gabriel-lepetitaimon/VoxPopuli/PCB/Project Outputs for VoxPopuli/Job1.PDF

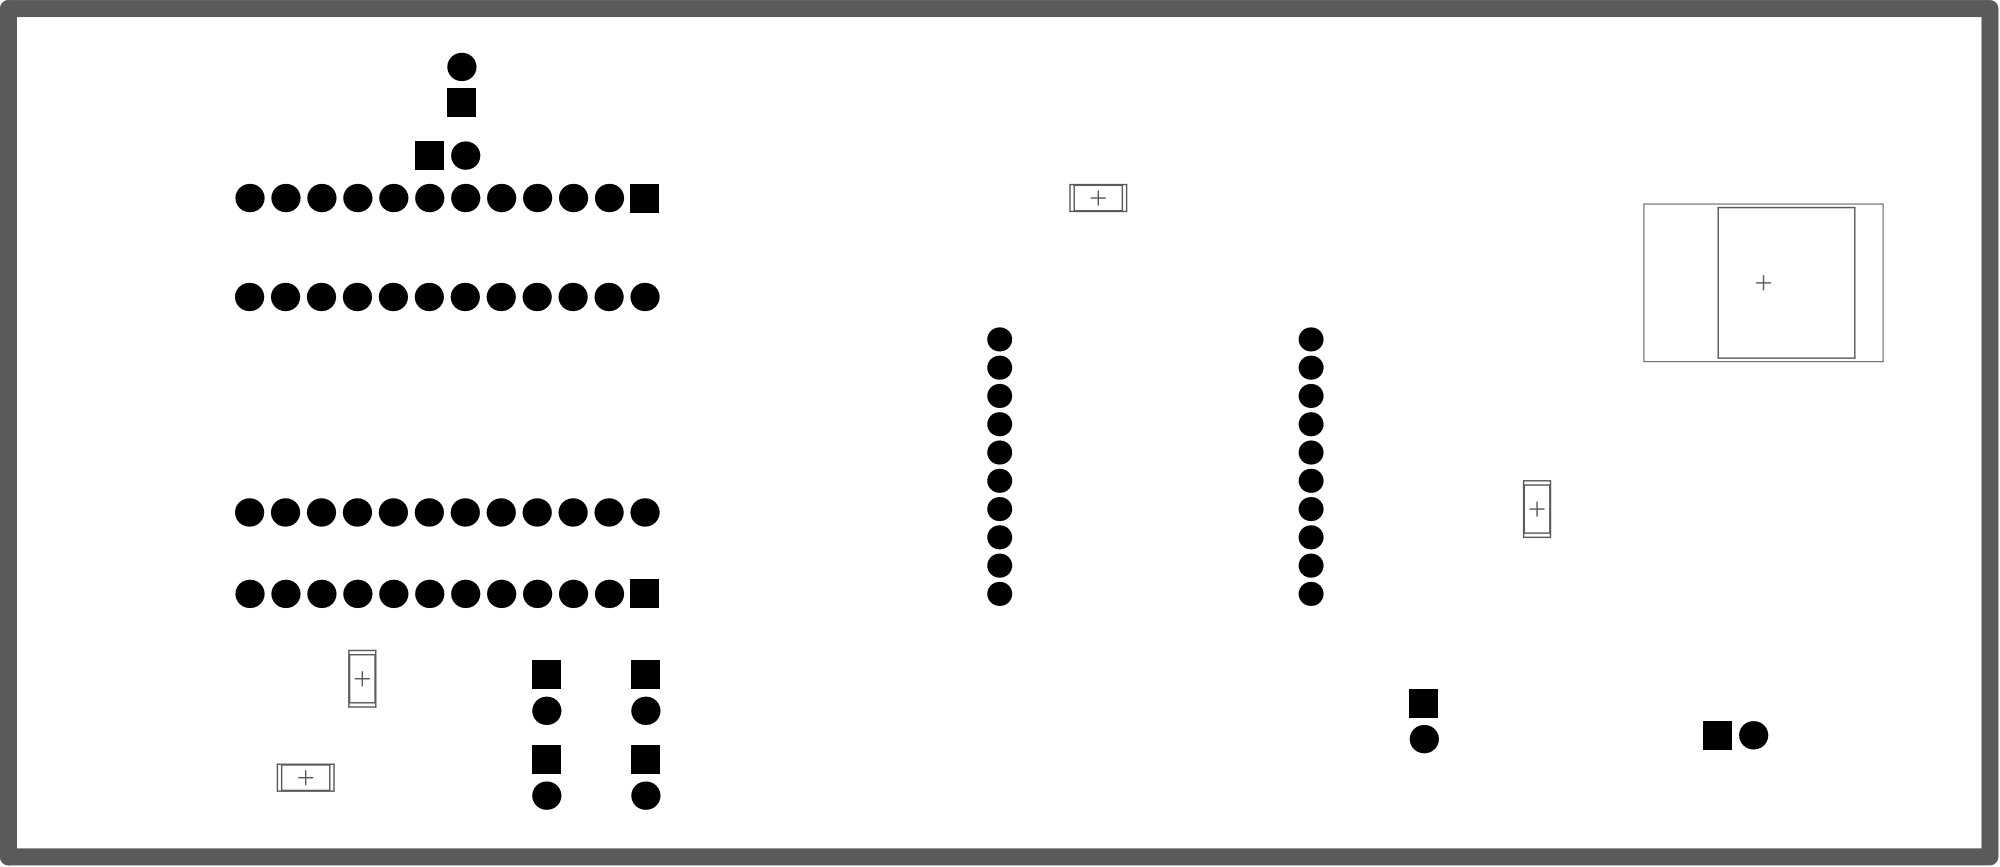
[picture p23: page 1]

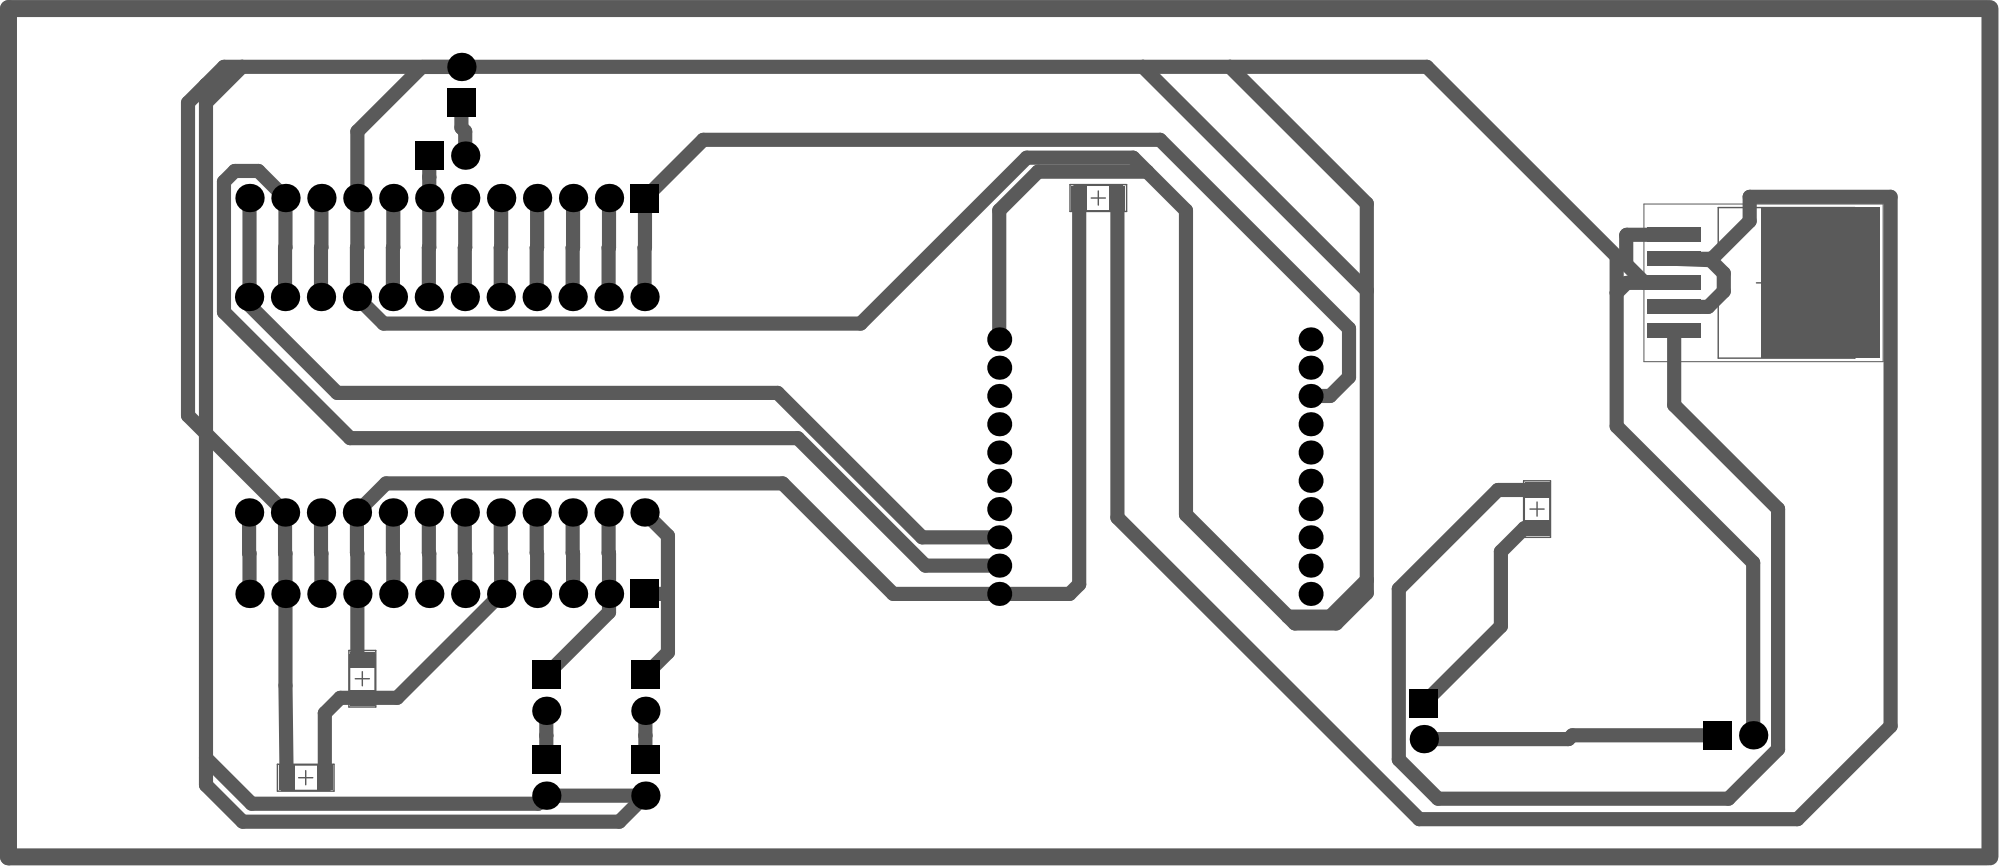
[picture p24: page 2]

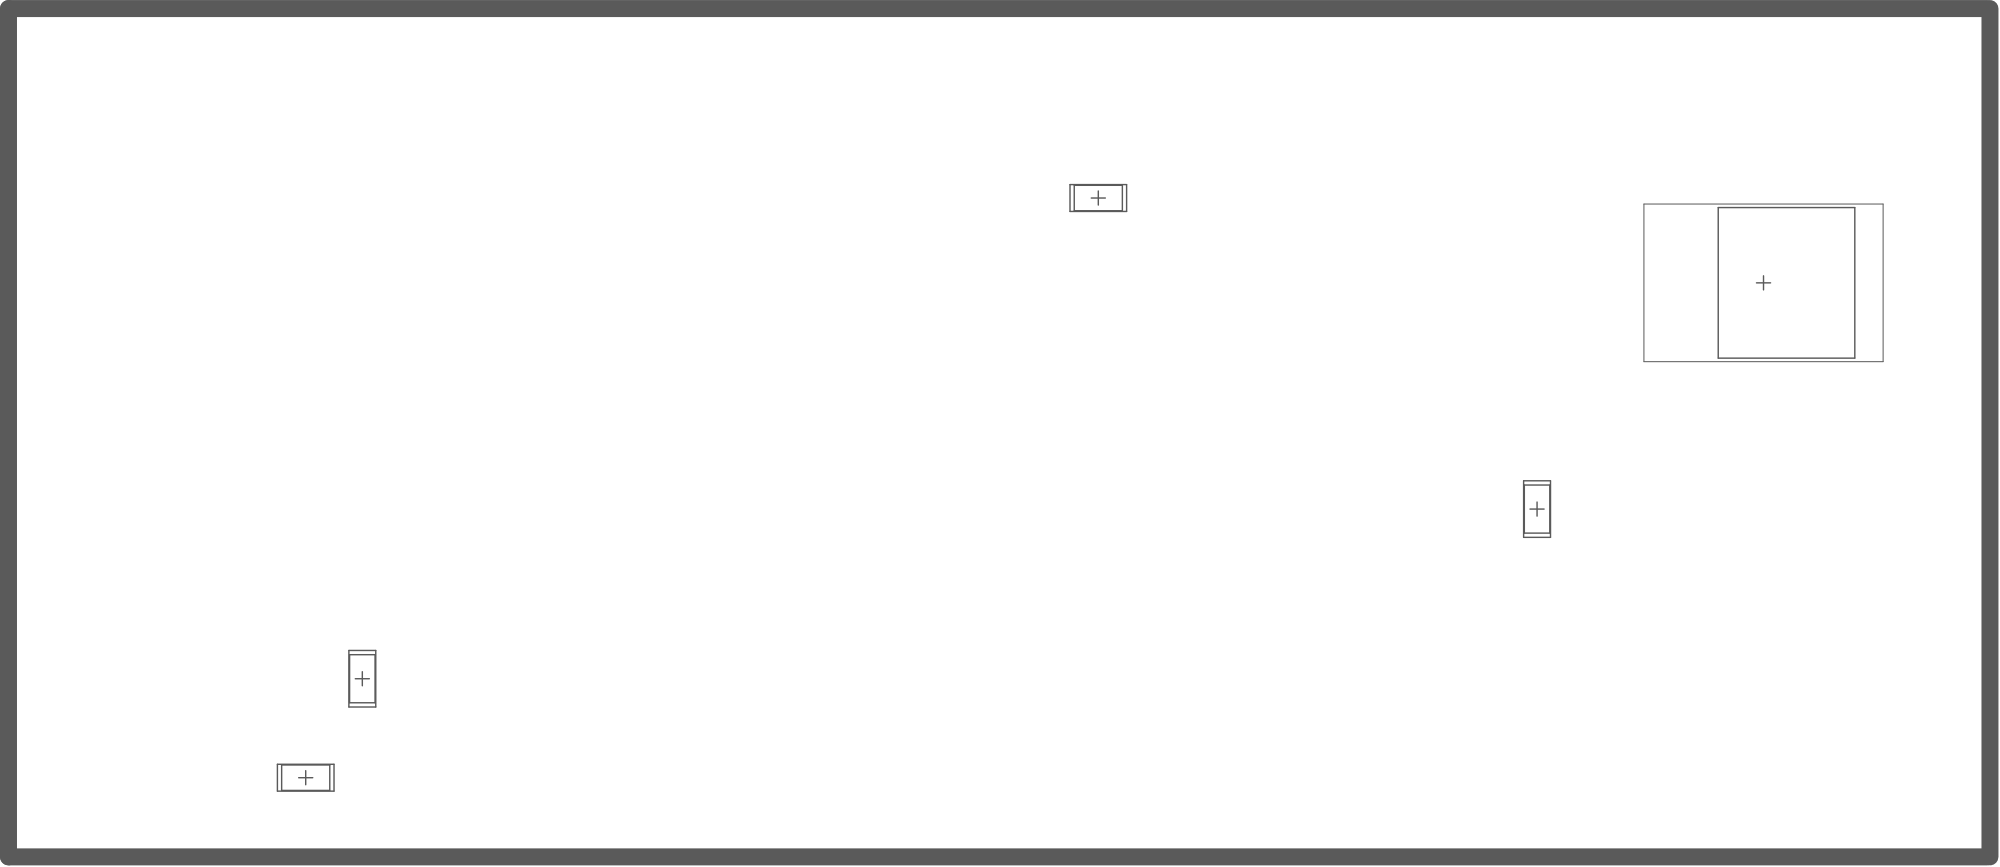
[picture p25: page 3]

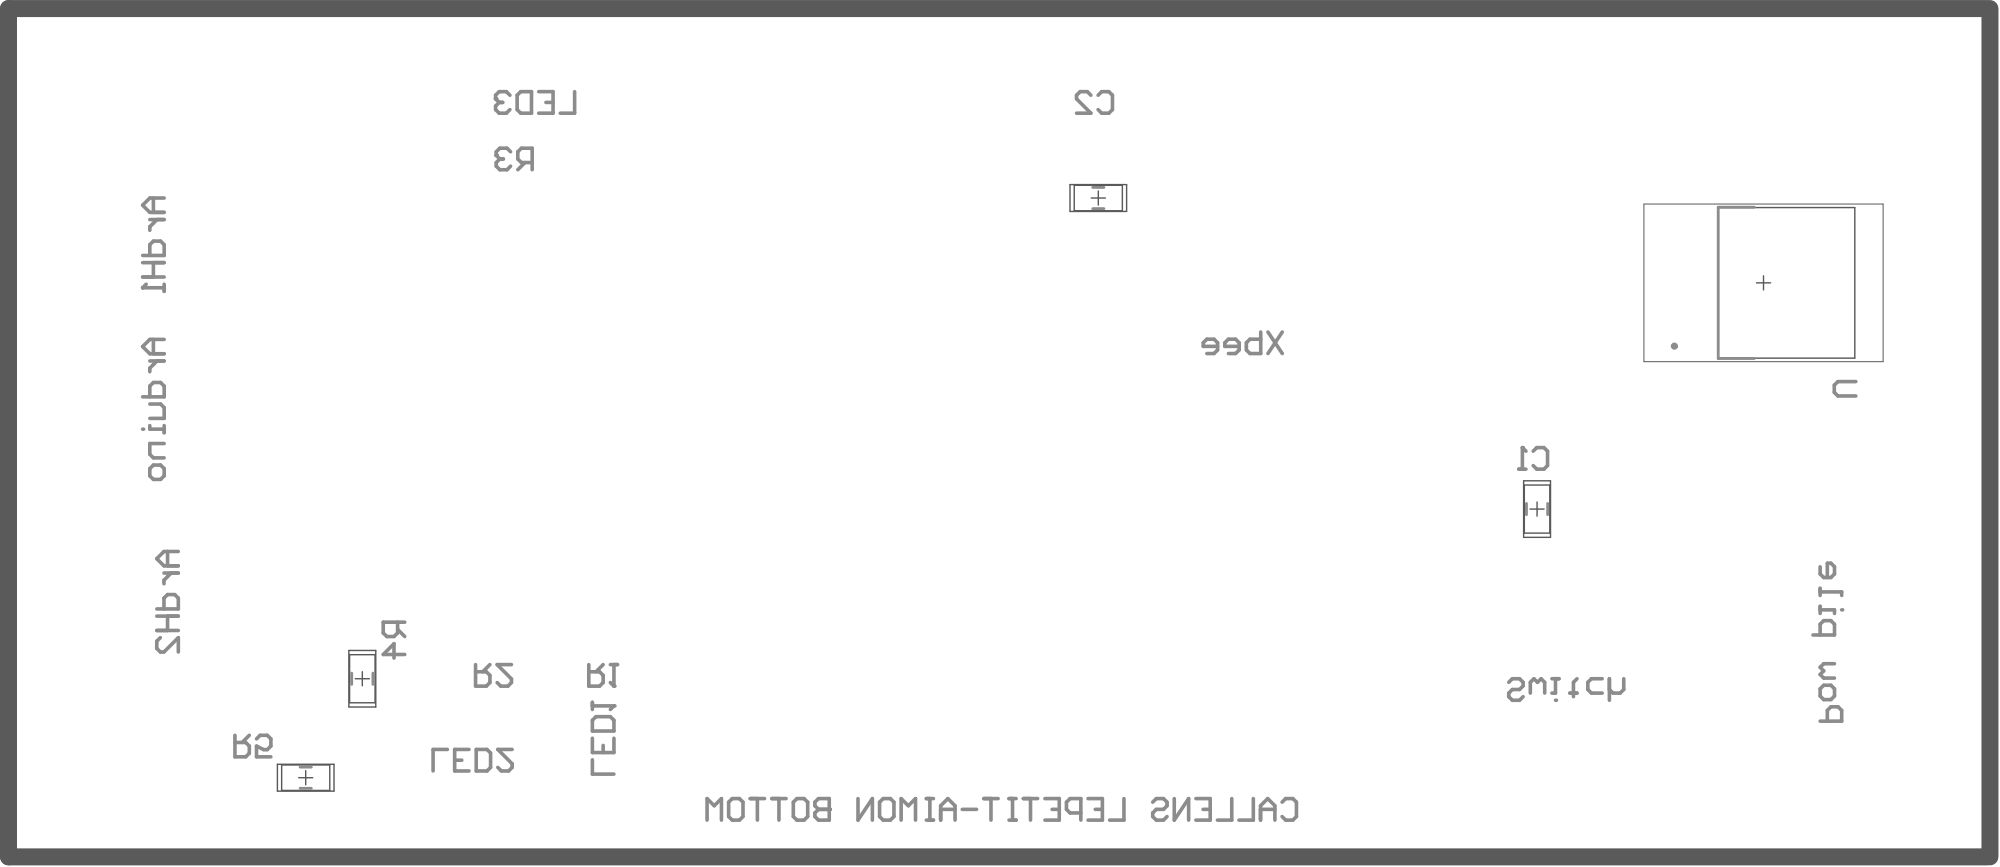
[picture p26: page 4]

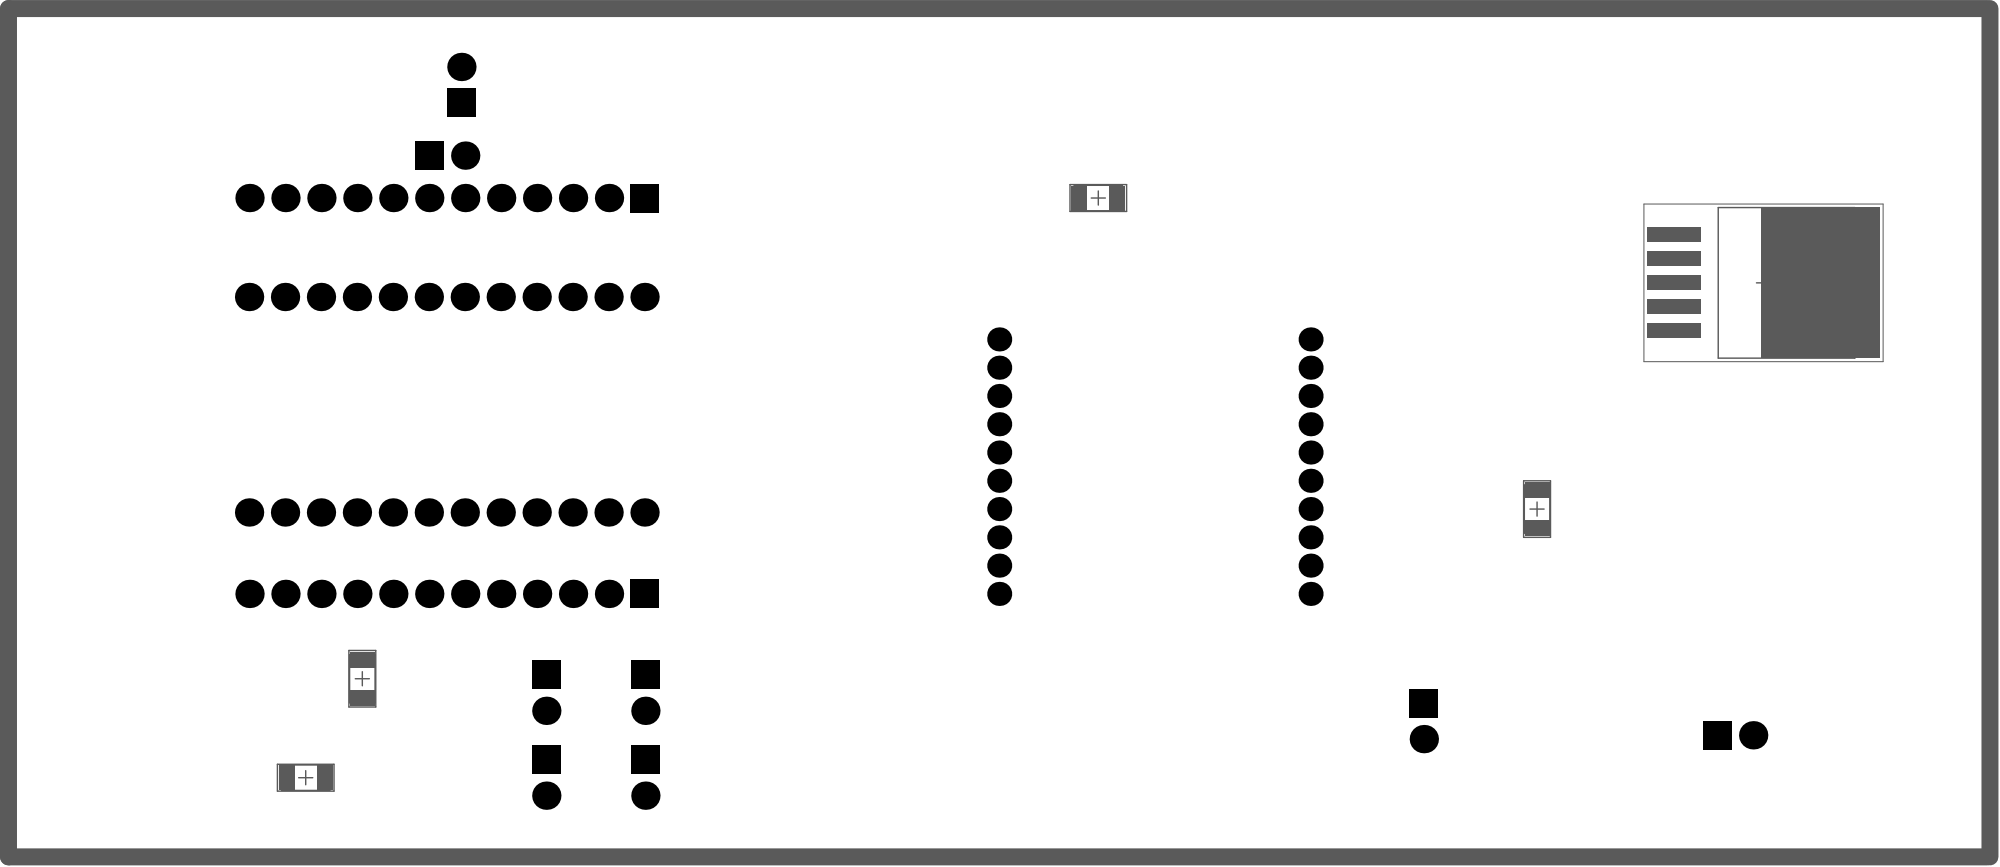
[picture p27: page 9]

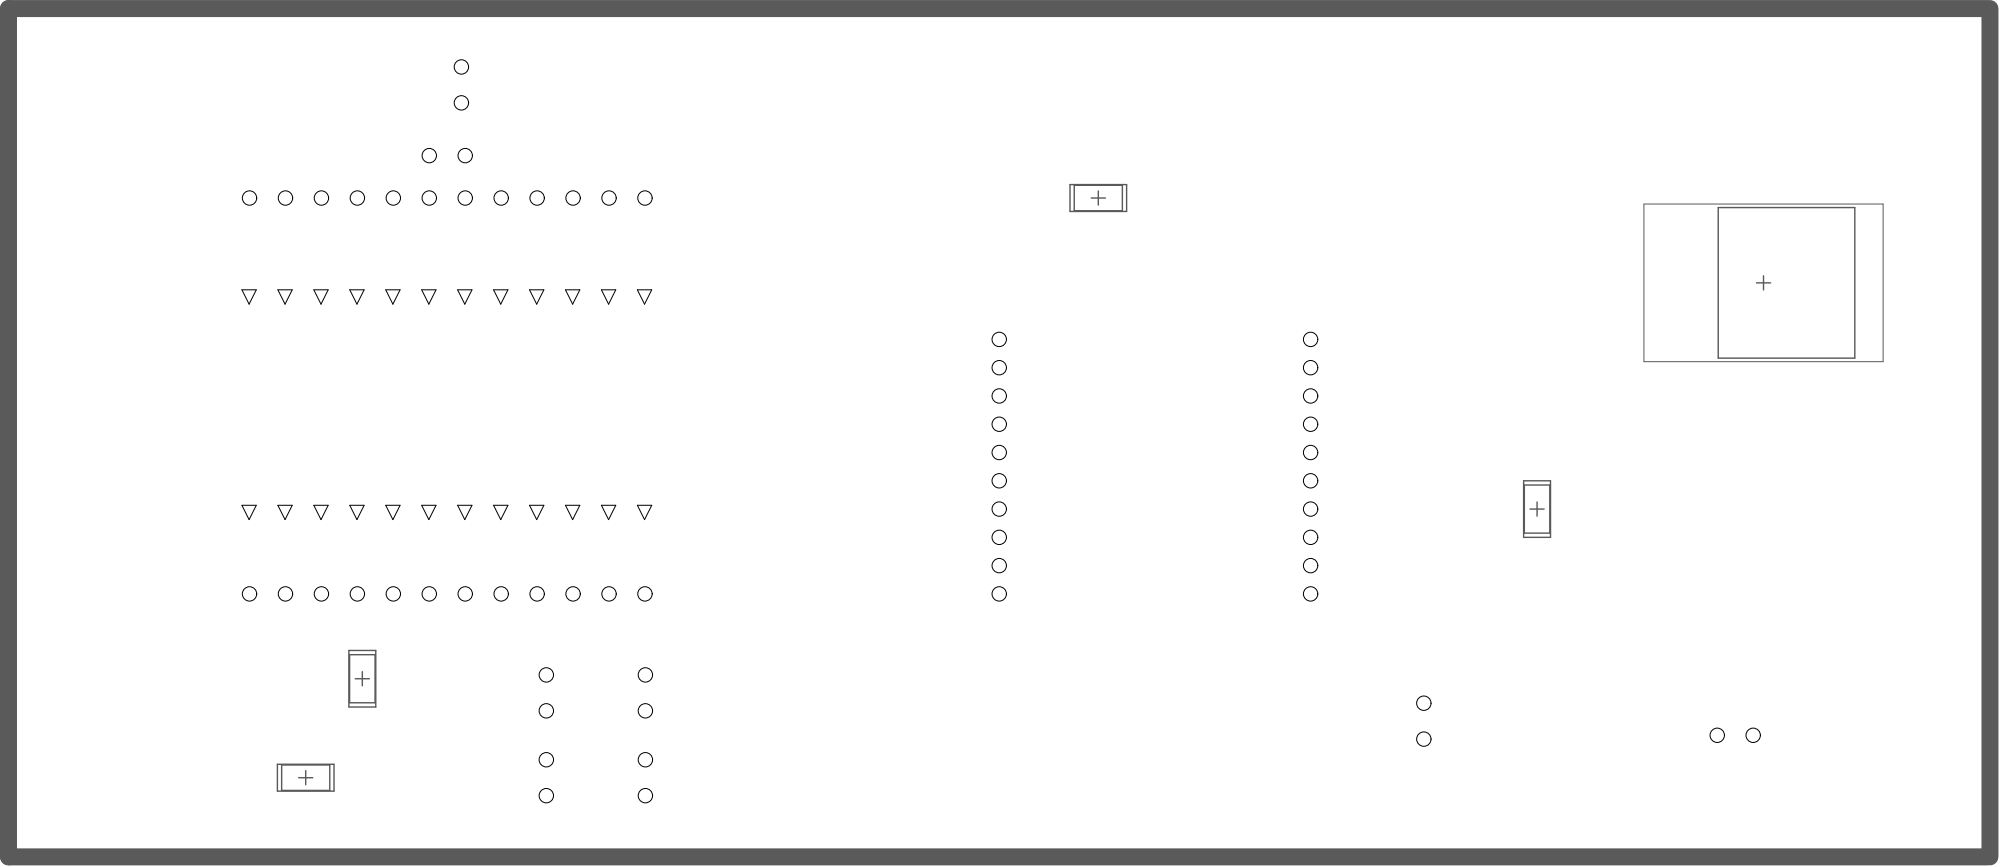
[picture p28: page 10]

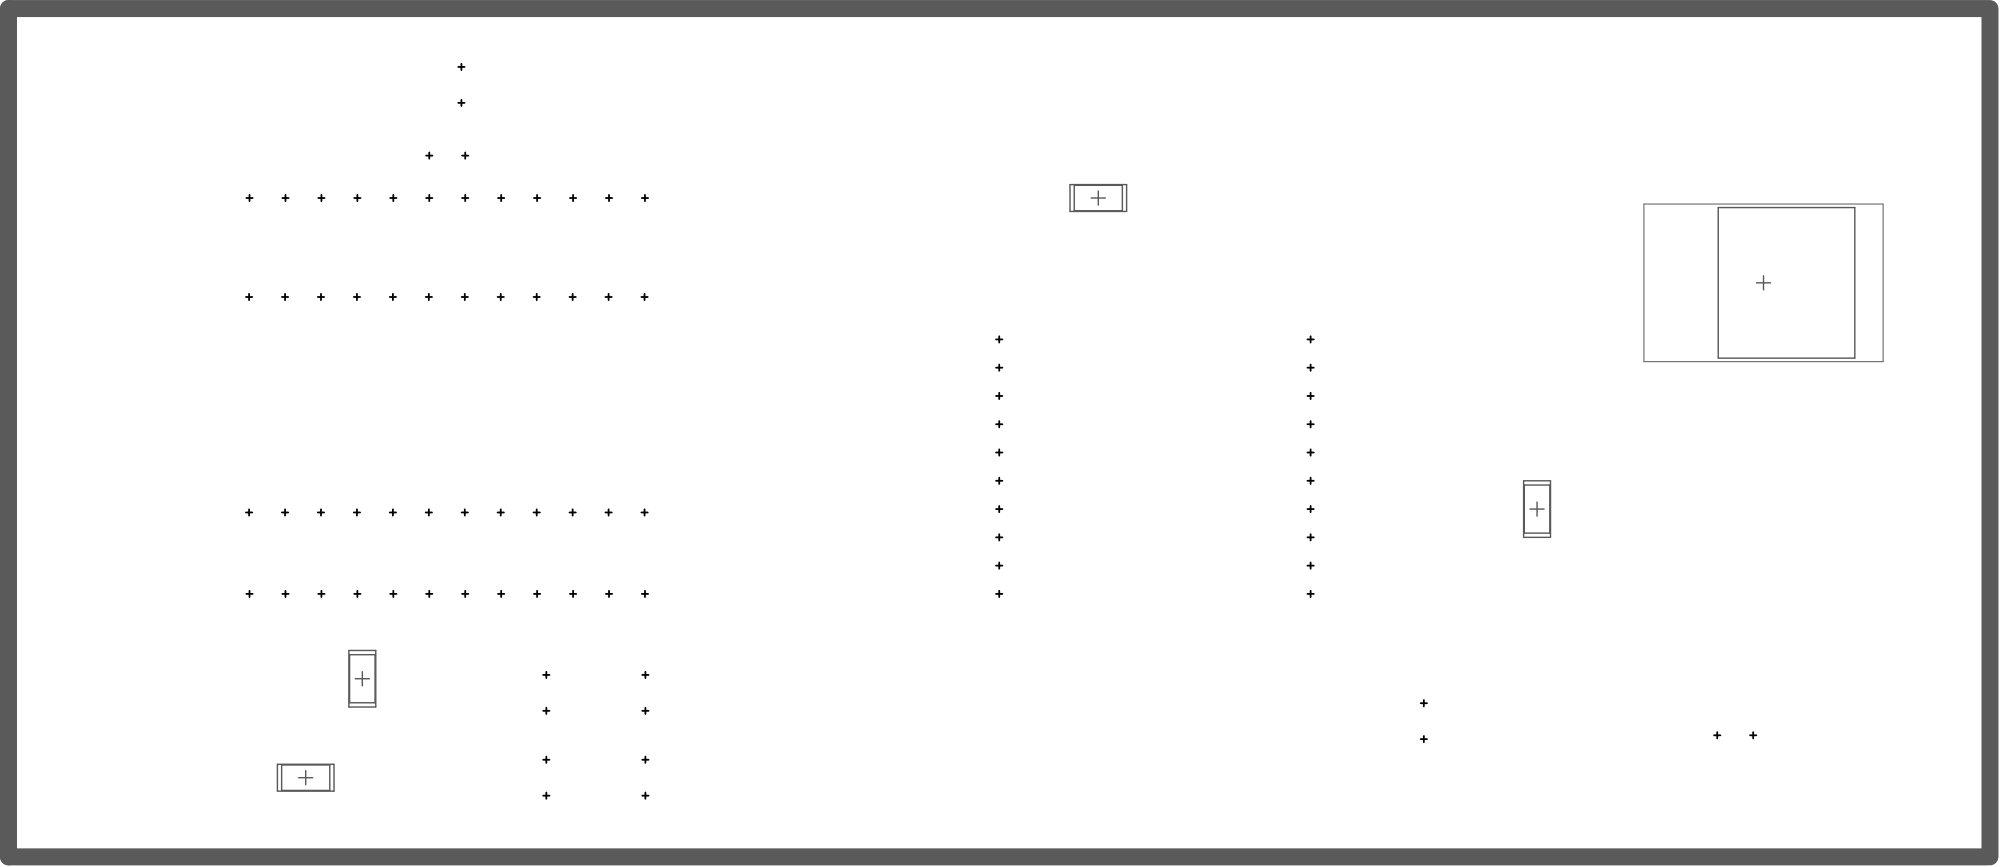
[picture p29: page 11]
