gabriel-lepetitaimon/VoxPopuli/PCB/Project Outputs for VoxPopuli/PCB_VoxPopuli_PRT_CALLENS.PDF

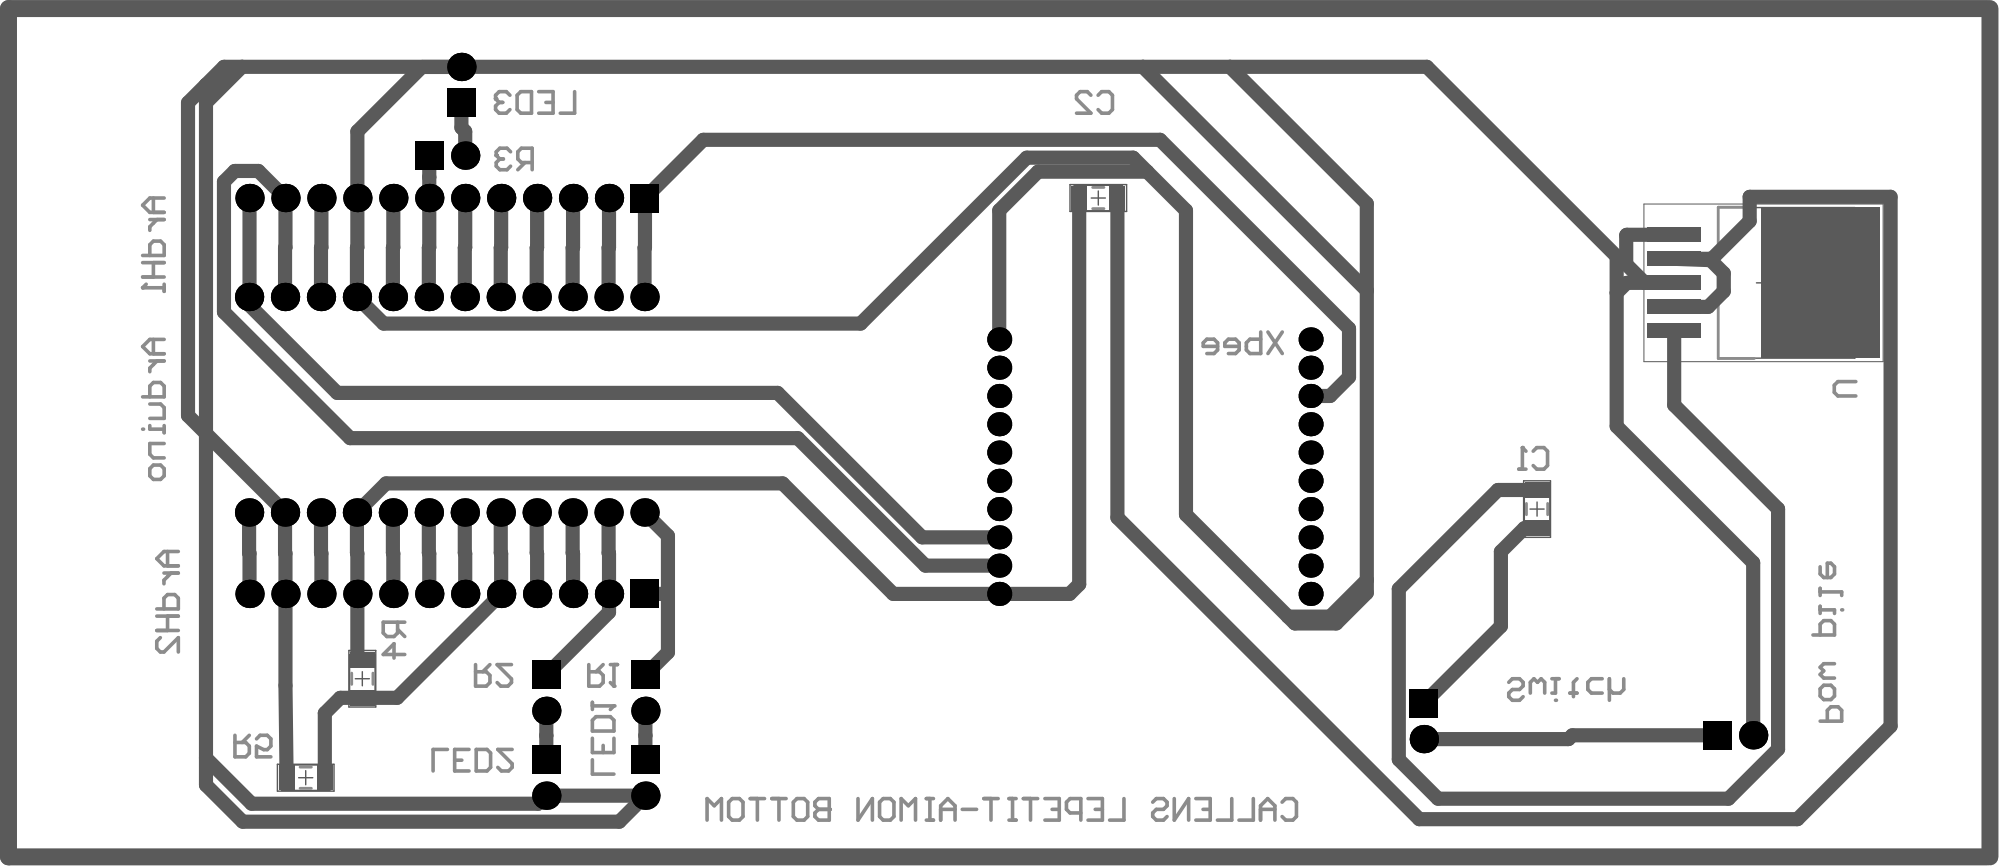
[picture p30: page 1]
