gabriel-lepetitaimon/VoxPopuli/(list of files, drawings)

Other design files:
PCB/Arduino System.SchLib
PCB/Arduino.PcbLib
PCB/VoxPopuli.PcbDoc
PCB/VoxPopuli.PcbLib
PCB/VoxPopuli.PrjPCB
PCB/VoxPopuli.SchDoc
PCB/VoxPopuli.SCHLIB
