gabriel-lepetitaimon/VoxPopuli/Software/src/Deamon/model/model.h

#ifndef JSONMODEL_H
#define JSONMODEL_H

#include <QObject>
#include <QString>
#include <QFile>
#include <QJsonDocument>
#include <QJsonObject>
#include <QFileSystemWatcher>
#include <QTimer>
#include <QVariant>
#include <functional>

#include <QDebug>

class JSonNode;
class JSonModel;

class JSonNode: public QObject
{
    Q_OBJECT

public:
    enum SetError{
        SameValue = -1,
        NoError = 0,
        DoesNotExist,
        ReadOnly,
        WrongArg
    };

    enum JSonNodeFlag{
        NO_JSON_FLAG = 0,
        RENAMEABLE = 0x01
    };


    const QString&      name()          const {return _name;}
    JSonNode*           nodeAt(QString name);
    JSonNode*           parentNode()    const {return _parentNode;}

    QString             address() const;
    QVariant get(const QString& name) const;
    bool getToString(const QString& name, QString &result) const;

    void printOut();
    virtual QString print() const;
    QStringList variablesNames() const;

    bool populateNode(const QJsonObject &data);

    const QMap<QString,QString> &getHelp(bool function);

    virtual ~JSonNode();

public slots:
    SetError set(const QString& name, const QString& value);
    bool call(const QString& functionName, const QStringList& arg, const std::function<void(QString)> &returnCb=[](QString){});

signals:
    void out(QString data);

protected:
    JSonNode(QString name, JSonNode *parent, const JSonNodeFlag& flags = NO_JSON_FLAG);

    virtual void updateParentJSon();
    virtual bool createSubNode(QString name, const QJsonObject& data);
    void addSubNode(JSonNode* node);
    void removeSubNode(JSonNode* node);
    void clearJsonData();

    virtual SetError setValue(QString name, QString value);
    JSonNode::SetError setString(QString name, QString value);
    SetError setNumber(QString name, QString value);
    SetError setNumber(QString name, double value);
    SetError setBool(QString name, QString value);
    SetError setBool(QString name, bool value);
    virtual SetError parseArray(QString name, QStringList value);
    virtual void valueChanged(QString name);

    virtual bool execFunction(QString function, QStringList args, const std::function<void(QString)>& cb=[](QString){});
    void printOut(QString msg);
    virtual void generateHelp(bool function) = 0;
    void addHelp(QString name, QString doc, bool function);
    QString helpString();

    bool rename(QString name);

    QString _name;
    const JSonNodeFlag _flags;
    QJsonObject _jsonData;
    JSonNode* _parentNode;

private:
    QList<JSonNode*> _subnodes;
    QMap<QString,QString> * _helpFunction = 0;
    QMap<QString,QString> * _helpVariables = 0;
};


#define JSON QDir::current().filePath(_name+".json")
class JSonModel : public JSonNode
{
    Q_OBJECT

public:
    JSonNode *nodeByAddress(QString address);
    virtual ~JSonModel();

    void init();

public slots:
    bool loadFile(QString path);
    bool saveToFile(QString path);
    bool resetFile();
    bool initFile();


protected:
    explicit JSonModel(QString name);
    void updateParentJSon();

protected slots:
    bool parseJSonFile();
    bool writeJSonFile();

signals:
    void startTimer();

private:
    void cleanJSon();

    QJsonDocument _jsonDoc;
    QFileSystemWatcher _watch;
    QTimer timer;

};

#endif // JSONMODEL_H
