gabriel-lepetitaimon/VoxPopuli/Software/src/Deamon/model/patch.cpp

#include <QJsonArray>

#include "patch.h"

#include "networkmodel.h"
#include "virtualnetwork.h"

/********************************************
 *              Patch                      *
 *******************************************/

Patch::Patch(NetworkModel *model)
    : JSonNode("Patch", model), _model(model)
{

}

bool Patch::execFunction(QString function, QStringList args, const std::function<void (QString)> &returnCb)
{
    if(function=="connect"){
        if(args.size()<2){
            returnCb("#Error: Wrong arguments number, expected remote and virtual remote names");
            return true;
        }
        addLink(args[0], args[1]);
        return true;
    }else if(function =="disconnect"){
        if(args.size()<2){
            returnCb("#Error: Wrong arguments number, expected remote and virtual remote names");
            return true;
        }
        removeLink(args[0], args[1]);
        return true;
    }else if(function == "disconnectRemote"){
        if(args.size()<1){
            returnCb("#Error: Wrong arguments number, expected remote name");
            return true;
        }
        removeRemoteLinks(args[0]);
        return true;
    }else if(function == "disconnectVirtual" || function == "disconnectVirtualRemote" || function == "disconnectVirtualGroup"){
        if(args.size()<1){
            returnCb("#Error: Wrong arguments number, expected remote name");
            return true;
        }
        removeVirtualLinks(args[0]);
        return true;
    }
    return false;
}

JSonNode::SetError Patch::parseArray(QString name, QStringList value)
{
    foreach(QString vName, value){
        if(!addEntry(name, vName))
            return WrongArg;
    }
    return NoError;
}

void Patch::generateHelp(bool function)
{
    if(function){
        addHelp("connect( remote, virtual )", "Create a link between a remote and a virtual remote or group", true);
        addHelp("disconnect( remote, virtual )", "Delete a link between a remote and a virtual remote or group", true);
        addHelp("disconnectRemote( remote )", "Delete all the links from a remote", true);
        addHelp("disconnectVirtual( virtual )", "Delete all the links from a virtual remote or group", true);
        addHelp("disconnectVirtualRemote( virtualRemote )", "Delete all the links from a virtual remote", true);
        addHelp("disconnectVirtualGroup( virtualGroup )", "Delete all the links from a virtual group", true);
    }
}


//  -----------  LINK HANDLER  -------------

bool Patch::addEntry(QString rName, QString vName)
{
    auto rEntry = _remoteToVirtual.find(rName);
    if(rEntry == _remoteToVirtual.end())
        _remoteToVirtual.insert(rName, QStringList(vName));
    else if(!rEntry.value().contains(vName))
        rEntry.value().append(vName);
    else
        return false;

    auto vEntry = _virtualToRemote.find(vName);
    if(vEntry == _virtualToRemote.end())
        _virtualToRemote.insert(vName, QStringList(rName));
    else if(!vEntry.value().contains(rName))
        vEntry.value().append(rName);
    else
        return false;

    VirtualGroup *group = 0;
    VirtualRemote* vRemote = 0;
    if(SEventModel::ptr()){
        group = SEventModel::ptr()->virtualNet()->groupByName(vName);
        vRemote = SEventModel::ptr()->virtualNet()->remoteByName(vName);
    }
    if(group)
        group->removeSlave(rName);
    else if(vRemote)
        vRemote->updateVirtualRemote();

    return true;
}

bool Patch::removeLink(QString rName, QString vName)
{
    auto rEntry = _remoteToVirtual.find(rName);
    if(rEntry==_remoteToVirtual.end())
        return false;
    mutex.lock();
    if(rEntry->removeOne(vName)){
        QJsonArray a = _jsonData[rName].toArray();
        for(auto it = a.begin(); it!=a.end(); it++){
            if((*it).toString()==vName){
                a.erase(it);
                break;
            }
        }
        if(!a.isEmpty())
            _jsonData[rName] = a;
        else
            _jsonData.remove(rName);
        valueChanged(rName);
    }else{
        mutex.unlock();
        return false;
    }

    if(rEntry->isEmpty())
        _remoteToVirtual.erase(rEntry);

    auto vEntry = _virtualToRemote.find(vName);
    if(vEntry != _virtualToRemote.end())
        vEntry->removeOne(rName);
    else{
        mutex.unlock();
        return false;
    }

    if(vEntry->isEmpty())
        _virtualToRemote.erase(vEntry);

    mutex.unlock();

    VirtualGroup *group = SEventModel::ptr()->virtualNet()->groupByName(vName);
    VirtualRemote* vRemote = SEventModel::ptr()->virtualNet()->remoteByName(vName);
    if(group)
        group->removeSlave(rName);
    else if(vRemote)
        vRemote->updateVirtualRemote();

    return true;
}

bool Patch::addLink(QString rName, QString vName)
{
    if(!addEntry(rName, vName))
        return false;

    QJsonArray a;
    auto link = _jsonData.find(rName);
    if(link!=_jsonData.end())
        a = (*link).toArray();
    a.push_back(vName);
    _jsonData[rName]=a;
    valueChanged(rName);

    return true;
}

bool Patch::removeRemoteLinks(QString rName)
{
    auto rEntry = _remoteToVirtual.find(rName);
    if(rEntry == _remoteToVirtual.end())
        return false;

    mutex.lock();
    foreach(QString vName, rEntry.value()){
        auto vEntry = _virtualToRemote.find(vName);
        if(vEntry != _virtualToRemote.end()){
            vEntry->removeOne(rName);
            if(vEntry->isEmpty())
                _virtualToRemote.erase(vEntry);
        }
        VirtualGroup *group = SEventModel::ptr()->virtualNet()->groupByName(vName);
        VirtualRemote* vRemote = SEventModel::ptr()->virtualNet()->remoteByName(vName);
        if(group)
            group->removeSlave(rName);
        else if(vRemote)
            vRemote->updateVirtualRemote();
    }

    _jsonData.remove(rName);
    valueChanged(rName);
    _remoteToVirtual.erase(rEntry);
    mutex.unlock();

    return true;
}

bool Patch::removeVirtualLinks(QString vName)
{
    auto vEntry = _virtualToRemote.find(vName);
    if(vEntry == _virtualToRemote.end())
        return false;

    VirtualGroup *group = SEventModel::ptr()->virtualNet()->groupByName(vName);
    VirtualRemote* vRemote = SEventModel::ptr()->virtualNet()->remoteByName(vName);

    mutex.lock();
    foreach(QString rName, vEntry.value()){
        auto rEntry = _remoteToVirtual.find(rName);
        if(rEntry==_remoteToVirtual.end())
            continue;

        if(rEntry->removeOne(vName)){
            if(rEntry->isEmpty())
                _remoteToVirtual.erase(rEntry);

            QJsonArray a = _jsonData[rName].toArray();
            for(auto it = a.begin(); it!=a.end(); it++){
                if((*it).toString()==vName){
                    a.erase(it);
                    break;
                }
            }
            if(!a.isEmpty())
                _jsonData[rName] = a;
            else
                _jsonData.remove(rName);
            valueChanged(rName);
        }

        if(group)
            group->removeSlave(rName);
        else if(vRemote)
            vRemote->updateVirtualRemote();

    }

    _virtualToRemote.erase(vEntry);

    mutex.unlock();
    return true;
}


bool Patch::addLink(Remote *remote, VirtualRemote *vRemote)
{
    return addLink(remote->name(), vRemote->name());
}

bool Patch::addLink(Remote *remote, VirtualGroup *vGroup)
{
    return addLink(remote->name(), vGroup->name());
}


bool Patch::removeLink(Remote *remote, VirtualRemote *vRemote)
{
    return removeLink(remote->name(), vRemote->name());
}

bool Patch::removeLink(Remote *remote, VirtualGroup *vGroup)
{
    return removeLink(remote->name(), vGroup->name());
}

bool Patch::removeLinks(Remote *remote)
{
    return removeRemoteLinks(remote->name());
}

bool Patch::removeLinks(VirtualRemote *vRemote)
{
    return removeVirtualLinks(vRemote->name());
}

bool Patch::removeLinks(VirtualGroup *vGroups)
{
    return removeVirtualLinks(vGroups->name());
}

void Patch::fastTriggerRemote(QString rName, FTriggerEvent e, const HexData &v)
{
    if(!SEventModel::ptr())
        return;

    QStringList vNames;
    mutex.lock();
    auto rEntry = _remoteToVirtual.find(rName);
    if(rEntry != _remoteToVirtual.end())
        vNames = rEntry.value();
    mutex.unlock();

    if(vNames.empty())
        return;

    SEventModel::ptr()->virtualNet()->fastTrigger(vNames, rName, e, v);
}

QList<Remote *> Patch::remoteList(QString virtualRemote)
{
    if(!SNetworkModel::ptr())
        return QList<Remote*>();

    QStringList rNames;
    mutex.lock();
    auto vEntry = _virtualToRemote.find(virtualRemote);
    if(vEntry!=_virtualToRemote.end())
        rNames = vEntry.value();
    mutex.unlock();

    QList<Remote*> remotes;
    foreach(QString rName, rNames){
        Remote* r = SNetworkModel::ptr()->remotes()->byName(rName);
        if(r)
            remotes.append(r);
    }
    return remotes;
}

QString eventName(FTriggerEvent e)
{
    switch(e){
    case UP:
        return "Up";
    case DOWN:
        return "Down";
    case RIGHT:
        return "Right";
    case LEFT:
        return "Left";
    case ACTION:
        return "Action";
    case LED:
        return "LED";
    }
    return "";
}

FTriggerEvent eventID(QString e)
{
    if(e == "Up")
        return UP;
    else if(e == "Down")
        return DOWN;
    else if(e == "Left")
        return LEFT;
    else if (e == "Right")
        return RIGHT;
    else if(e == "Action")
        return ACTION;

    return LED;
}
