gabriel-lepetitaimon/VoxPopuli/Software/src/Deamon/model/oscinterface.cpp

#include "oscinterface.h"
#include "networkmodel.h"

/********************************************
 *             OSC Interface                *
 *******************************************/
OscInterface::OscInterface(EventModel * eventModel)
    :JSonNode("OSC", eventModel)
{
    _oscListener = new qosc::Listener(this);
    _oscListener->addListener(this);
}
OscInterface::~OscInterface()
{
    delete _oscListener;
}

void OscInterface::setOscAddress(const QString& address)
{
    _oscAddress = address;
    if(!_oscAddress.startsWith('/')) _oscAddress.prepend('/');
    if(!_oscAddress.endsWith('/'))   _oscAddress.append('/');
    
    _oscListener->setAddressFilter(_oscAddress);
}

void OscInterface::setPort(int port)
{
    _oscListener->startServer(port);
}

void OscInterface::readOscMsg(QString addr, QVariantList args)
{
    QString simpleAddr(addr);
    simpleAddr.remove(0, _oscAddress.length());
    
    EmulatedRemote* r=0;
    if(args.size()>=1 && args.first()=="emulate"){
        if(simpleAddr.contains('/'))
            return;
        QString ipPort = "";
        if(args.size()>=2)
            ipPort = args.at(1).toString();
        SNetworkModel::ptr()->remotes()->emulateRemote(simpleAddr, addr, ipPort);
    }else if(r = SNetworkModel::ptr()->remotes()->byOSC(addr)){
        r->readOsc(args);
    }
}

JSonNode::SetError OscInterface::setValue(QString name, QString value)
{
    if(name=="address"){
        setOscAddress(value);
        return NoError;
    }else if(name=="port"){
        bool success;
        int port = value.toInt(&success);
        if(!success)
            return WrongArg;
        setPort(port);
        return NoError;
    }
    
    return JSonNode::setValue(name, value);
}

bool OscInterface::execFunction(QString function, QStringList args, const std::function<void (QString)> &returnCb)
{
    
    if(function == "sendTo" || function=="sendToAll"){
        int all = function=="sendToAll";
        if(args.size() < 3 - all ){
            returnCb("#Error: Wrong argument number");
            return true;
        }
        
        QString ip = "";
        if(!all)
            ip = args.at(0);
        
        bool ok = true;
        int port = args.at(1-all).toInt(&ok);
        if(!ok){
            returnCb("#Error: second argument shoud be a port");
            return true;
        }
        QString osc = args.at(2-all);
        
        QVariantList l;
        for(int i = 3-all; i<args.size(); i++){
            double a = args.at(i).toDouble(&ok);
            if(ok)
                l.append(a);
            else if(args.at(i).compare("true", Qt::CaseInsensitive))
                l.append(true);
            else if(args.at(i).compare("false", Qt::CaseInsensitive))
                l.append(false);
            else
                l.append(args.at(i));
        }
        if(all)
            qosc::sendMsg(port, osc, l);
        else if(!qosc::sendMsg(ip, port, osc, l))
            returnCb("#Error: \""+ip+"\" is not a valid network address");
            
        return true;
    }
    
    return false;
}

void OscInterface::generateHelp(bool function)
{
    if(!function){
        addHelp("address", "OSC address", false);
        addHelp("port", "OSC listening port", false);
    }else{
        addHelp("sendTo( ip, port, oscAddr, args ... )", "send an OSC event to a specific IPs", true);
        addHelp("sendToAll( port, oscAddr, args ... )", "send an OSC event to all network", true);
    }
}
