gabriel-lepetitaimon/VoxPopuli/(commit log)

2016-05-18 telnet LED handling
2016-05-20 Signal strength and remote disconnection update correctly.
    [model.cpp, model.h, networkmodel.cpp, networkmodel.h]
2016-05-20 Main arduino file needs to be in MAIN folder. Button handling working Active/Mute handling working Better Tx process, no sleep on pin function implemented yet
2016-05-21 Adding the possibility to rename remotes and various bugs fix
    [model.cpp, model.h, networkmodel.cpp]
2016-05-21 PWM working, button handling changed
2016-05-22 PIN ON SLEEP working : all the data in the buffer is sent when this pin goes to HIGH.
    ADC implemented but working on 10-bit so weird transmission happens: to be fixed
    [Main.ino]
2016-05-28 implémentation des 3 LED + control général ; renvoie des statuts active mute avec commande particulière renvoie des statuts LED si pas d'arguments ATTENION, changement de code commande LED général
2016-05-29 Fichiers PCB, design en cours : I don't know what I'm doing
    [Arduino System.SchLib, Arduino.PcbLib, VoxPopuli.PcbDoc, VoxPopuli.PcbLib, VoxPopuli.PrjPCB, VoxPopuli.SCHLIB, VoxPopuli.SchDoc]
2016-05-30 PDF dans job output;
    Fuck
    [VoxPopuli.PcbDoc, VoxPopuli.PcbLib, VoxPopuli.PrjPCB, VoxPopuli.SchDoc]
2016-06-01 Rename add doc files
    [Arduino System.SchLib, Arduino.PcbLib, VoxPopuli.PcbDoc, VoxPopuli.PcbLib, VoxPopuli.PrjPCB, VoxPopuli.SCHLIB, VoxPopuli.SchDoc]
2016-06-04 commit 4/6/16
    [VoxPopuli.PcbDoc, VoxPopuli.PrjPCB]
2016-10-26 Fix json synchronisation when removing a subnode.
    [model.cpp]
2016-11-16 Various fix on OscRemote
    [oscremote.cpp]
2016-11-16 Fix crash when closing
    [oscinterface.h]
2016-11-16 Fix osc address filter
